mosstech/MIDILOOP/schematics/MIDILOOP.Schematic.brd

## EAGLE design schematics/MIDILOOP.Schematic.brd (2016-02-27)

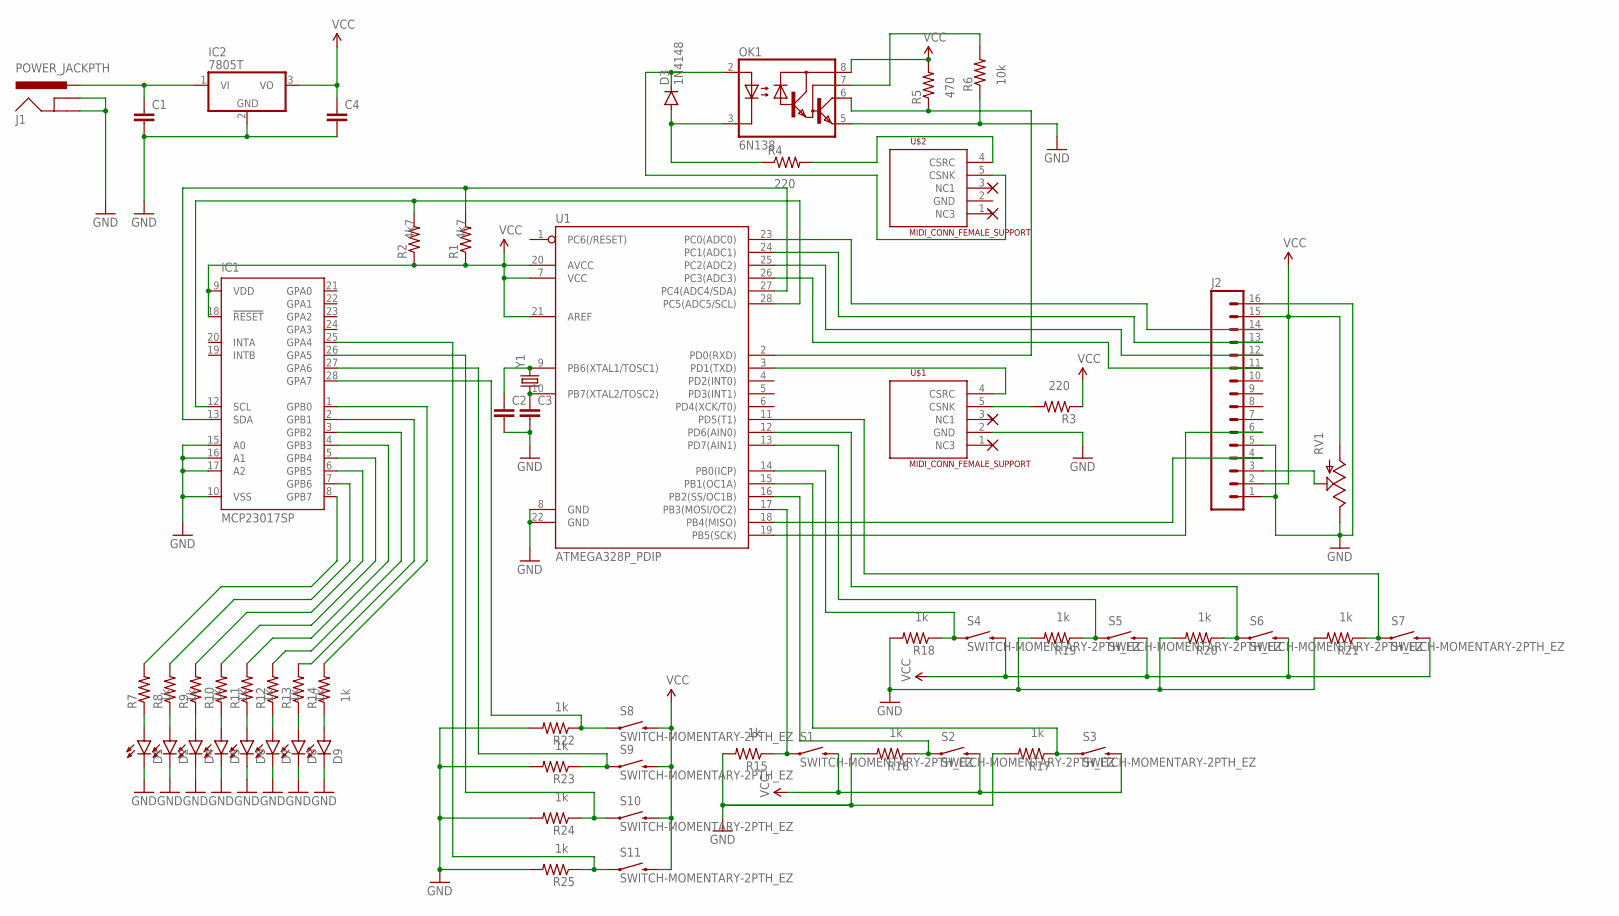
[picture p1: schematic MIDILOOP.Schematic.sch]

Parts:
C1, C4: CAPPTH1; CAP-PTH-5MM
C2, C3: CAPPTH; CAP-PTH-SMALL
D1, D2, D4, D5, D6, D7, D8, D9: LED3MM
D3: 1N4148; DIODE-1N4148
IC1: MCP23017SP; DIL28-3
IC2: 7805T; TO220H
J1: POWER_JACKPTH; POWER_JACK_PTH
J2: M16LONGPADS; 1X16_LONGPADS
OK1: 6N138; DIL08
R1, R2, R3, R4, R5, R6, R7, R8, R9, R10, R11, R12, R13, R14, R15, R16, R17, R18, R19, R20, R21, R22, R23, R24, R25: RESISTOREZ; AXIAL-0.3EZ
RV1: POTTRIM; TRIM_POT
S1, S2, S3, S4, S5, S6, S7, S8, S9, S10, S11: SWITCH-MOMENTARY-2PTH_EZ; TACTILE-PTH-EZ
U1: ATMEGA328P_PDIP; DIL28-3
U$1, U$2: MIDI_CONN_FEMALE_SUPPORT; DIN_5_FEMALE_SUPPORT
Y1: CRYSTALHC49US; HC49US

Connections:
GND: C1.2, C2.2, C3.2, C4.2, D1.K (C), D2.K (C), D4.K (C), D5.K (C), D6.K (C), D7.K (C), D8.K (C), D9.K (C), IC1.10 (VSS), IC1.15 (A0), IC1.16 (A1), IC1.17 (A2), IC2.2 (GND), J1.GND, J1.GNDBREAK, J2.1, J2.5, J2.16, OK1.5 (GND), R6.P$1 (1), R15.P$2 (2), R16.P$2 (2), R17.P$2 (2), R18.P$2 (2), R19.P$2 (2), R20.P$2 (2), R21.P$2 (2), R22.P$2 (2), R23.P$2 (2), R24.P$2 (2), R25.P$2 (2), RV1.2 (E), U1.8 (GND), U1.22 (GND), U$1.2 (GND)
unnamed: C2.1, U1.9 (PB6(XTAL1/TOSC1)), Y1.2
unnamed: U1.3 (PD1(TXD)), U$1.4 (CSRC)
unnamed: IC1.13 (SDA), R1.P$2 (2), U1.27 (PC4(ADC4/SDA))
unnamed: IC1.12 (SCL), R2.P$2 (2), U1.28 (PC5(ADC5/SCL))
unnamed: C3.1, U1.10 (PB7(XTAL2/TOSC2)), Y1.1
unnamed: R3.P$2 (2), U$1.5 (CSNK)
unnamed: R4.P$2 (2), U$2.4 (CSRC)
unnamed: D3.C, OK1.2 (A), U$2.5 (CSNK)
unnamed: D3.A, OK1.3 (C), R4.P$1 (1)
unnamed: IC1.8 (GPB7), R7.P$2 (2)
unnamed: OK1.6 (VO), R5.P$1 (1), U1.2 (PD0(RXD))
unnamed: OK1.7 (VB), R6.P$2 (2)
unnamed: D1.A, R7.P$1 (1)
unnamed: IC1.7 (GPB6), R8.P$2 (2)
unnamed: D2.A, R8.P$1 (1)
unnamed: IC1.6 (GPB5), R9.P$2 (2)
unnamed: IC1.4 (GPB3), R11.P$2 (2)
unnamed: IC1.3 (GPB2), R12.P$2 (2)
unnamed: IC1.2 (GPB1), R13.P$2 (2)
unnamed: IC1.1 (GPB0), R14.P$2 (2)
unnamed: D4.A, R9.P$1 (1)
unnamed: D5.A, R10.P$1 (1)
unnamed: D6.A, R11.P$1 (1)
unnamed: D7.A, R12.P$1 (1)
unnamed: D8.A, R13.P$1 (1)
unnamed: D9.A, R14.P$1 (1)
unnamed: R15.P$1 (1), S1.1, U1.17 (PB3(MOSI/OC2))
unnamed: R18.P$1 (1), S4.1, U1.14 (PB0(ICP))
unnamed: R16.P$1 (1), S2.1, U1.16 (PB2(SS/OC1B))
unnamed: R17.P$1 (1), S3.1, U1.15 (PB1(OC1A))
unnamed: R19.P$1 (1), S5.1, U1.13 (PD7(AIN1))
unnamed: J2.3, RV1.1 (S)
unnamed: R20.P$1 (1), S6.1, U1.12 (PD6(AIN0))
unnamed: J2.4, U1.18 (PB4(MISO))
unnamed: J2.6, U1.19 (PB5(SCK))
unnamed: R21.P$1 (1), S7.1, U1.11 (PD5(T1))
unnamed: J2.14, U1.23 (PC0(ADC0))
unnamed: J2.11, U1.26 (PC3(ADC3))
unnamed: J2.12, U1.25 (PC2(ADC2))
unnamed: J2.13, U1.24 (PC1(ADC1))
unnamed: IC1.27 (GPA6), R23.P$1 (1), S9.1
unnamed: IC1.28 (GPA7), R22.P$1 (1), S8.1
unnamed: IC1.26 (GPA5), R24.P$1 (1), S10.1
unnamed: IC1.25 (GPA4), R25.P$1 (1), S11.1
unnamed: C1.1, IC2.1 (VI), J1.PWR
unnamed: IC1.5 (GPB4), R10.P$2 (2)
VCC: C4.1, IC1.9 (VDD), IC1.18 (!RESET), IC2.3 (VO), J2.2, J2.15, OK1.8 (VCC), R1.P$1 (1), R2.P$1 (1), R3.P$1 (1), R5.P$2 (2), RV1.3 (A), S1.3 (2), S2.3 (2), S3.3 (2), S4.3 (2), S5.3 (2), S6.3 (2), S7.3 (2), S8.3 (2), S9.3 (2), S10.3 (2), S11.3 (2), U1.7 (VCC), U1.20 (AVCC), U1.21 (AREF)

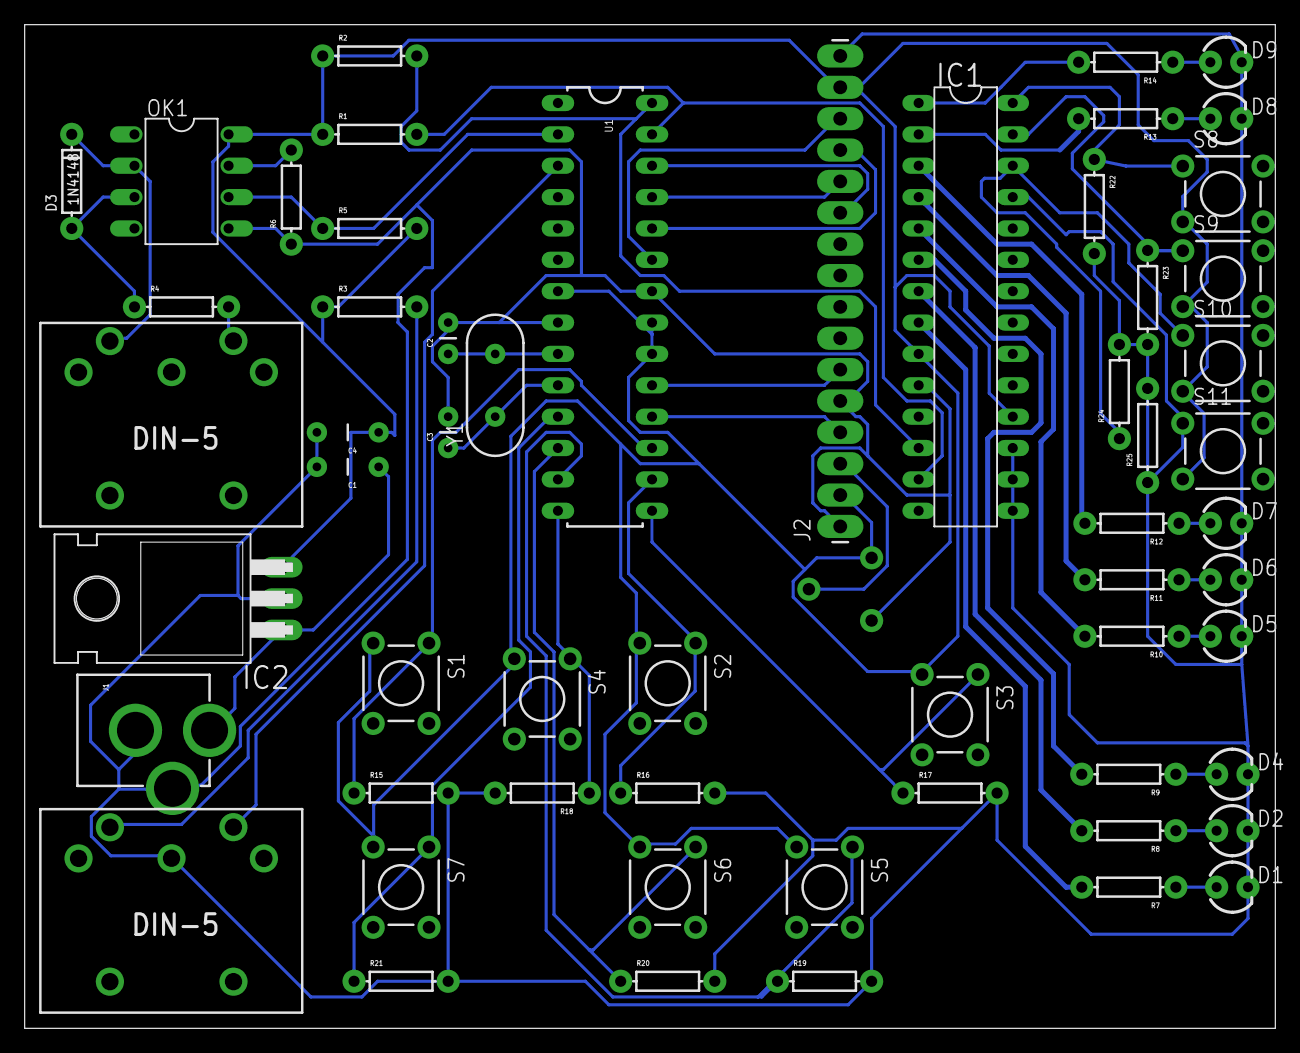
[picture p2: board MIDILOOP.Schematic.brd from above]

Board: 2 copper layers, 101.3 x 81.3 mm, 59 parts (0 on the bottom side), 48 nets.
