mosstech/MIDILOOP/(commit log)

2016-02-27 Initial Commit. Pending testing.
    [MIDILOOP.Schematic.brd, MIDILOOP.Schematic.sch]
2016-03-20 Pin and LED updates
    Updated pin numbers and LED display alignment
2016-03-20 LCD Updates
    Created intToString method to convert an int into a 2-length string.
    Also fixed quantize display justification
    [MIDILOOP.ino]
